sem1hX1/esp32MicroDronee/esp32MicroDronee-main/img/back.jpg

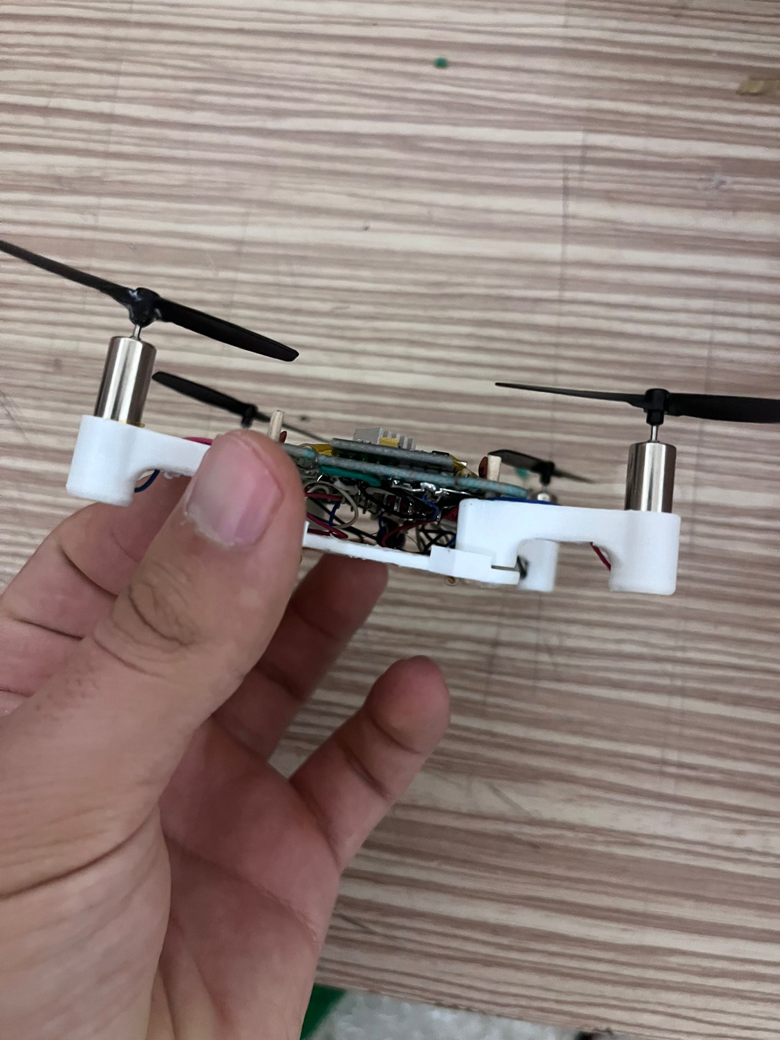
esp32MicroDronee-main/img/back.jpg
