sem1hX1/esp32MicroDronee/(notices)

Notices in the files:
README.md:
License: MIT
